oritomov/cdc/README.md

# Emulator (Arduino & Raspbery Pi) for<br>Audi Gamma CC Bose CD Changer 

### Preface

This isn't my biggest project, but it is most complicated and related to too much unknown to me things. It is my first Python code and my first Arduino project.

### Hardware

Audi Gamma CC Bose (HU) is my auto cassette player. It has ability to rule a CD Changer, not directly, but via specific Audi Interface (AI).

#### Audi Gamma CC Bose - Head Unit (HU)

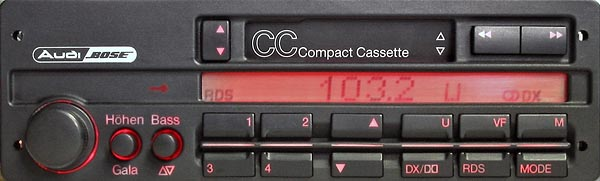
[picture p1: etc/img/Audo Gamma CC Bose.jpg]


#### Audi Interface 4A0 035 239, Blaupunkt 7 607 765 082 (AI) 

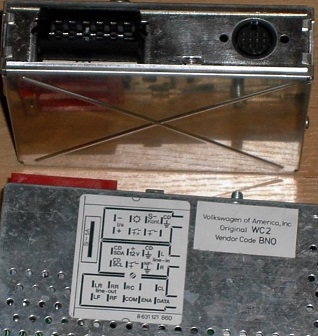
[picture p2: etc/img/4A0 035 239.jpg]

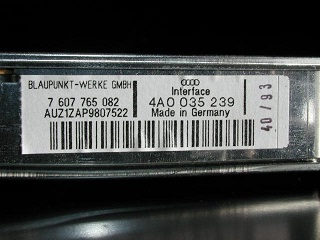
[picture p3: etc/img/Blaupunkt 7 607 765 082.jpg]


#### CD Changer (CDC)

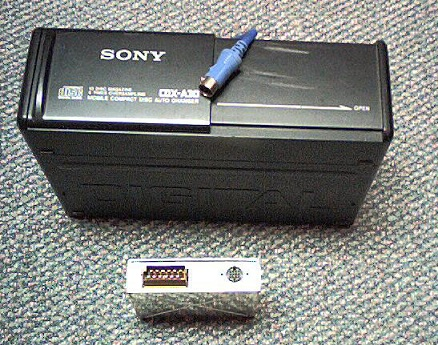
[picture p4: etc/img/CD_changer.jpg]


### I2C/TWI communication betwwen HU and AI

Even though communication with VAG's CD Changers is pretty well documented, I couldn't find any information about communication between my HU and the AI. This is what I surveyed.

The HU sends I2C/TWI signals to AI on 960 Hz (or sort of) to the address 0x40. ON is two bytes 0xA1 and 0x21, OFF is same bytes back order. Other signals what I riddle are from '^', 'v', '>>' and '<<' buttons hold and release. There are two more signals, one when HU doesn't like communication - I called "Cancel", and one more, what HU sends it from time to time instead of OFF.

#### OFF

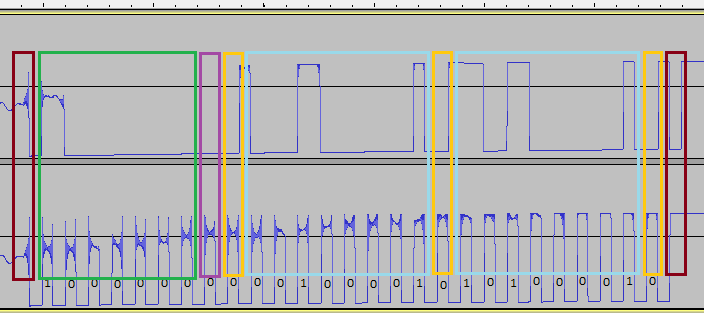
[picture p5: etc/img/off.png]


 * (Start)
 * 1000000 (7bit addrtess 0x40)
 * 0 (Write)
 * 0 (Ack)
 * 00100001 (8bit data 0x21)
 * 0 (Ack)
 * 10100001 (8bit data 0xA1)
 * 0 (Ack)
 * (Stop)
 
#### ON
 
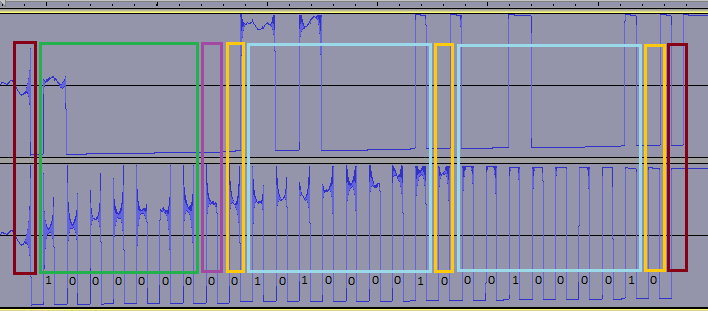
[picture p6: etc/img/on.png]


 * (Start)
 * 1000000 (7bit addrtess 0x40)
 * 0 (Write)
 * 0 (Ack)
 * 10100001 (8bit data 0xA1)
 * 0 (Ack)
 * 00100001 (8bit data 0x21)
 * 0 (Ack)
 * (Stop)

#### Display

Communication on the other direction is pretty ... incoherent. It looks like address and 3 bytes via I2C, but it is not. And there is no Ack signal in response. It should be around 30 ms after HU signal and after direction button release it repeats twice. And ditto any time when on display should appears something new. 

In order to display CD01TR01 it will looks like:

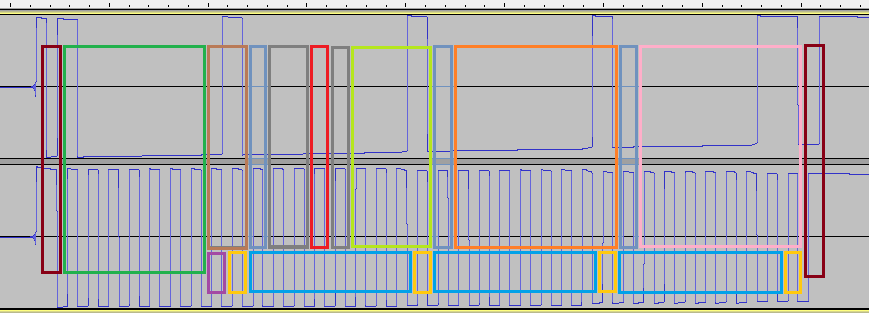
[picture p7: etc/img/gamma.png]


Down side I colored what it would look like if it was I2C. But it is:

 * (Start)
 * 1000000 (7bit address 0x40, same as I2C)
 * 01 (2 bits, similar to I2C Write & Ack, but there is no Ack level from the HU
 
------------------------------ 1st data chunk
 
 * 0 (1 bit, not used)
 * 00 (2 bits, ???)
 * 0 (1 bit, 1 means NO DISK)
 * 0 (1 bit, ???)
 * 0001 (4 bits, CD #)
 
------------------------------ 2nd data chunk
 
 * 0 (1 bit, not used)
 * 00000001 (8bit data TR #)
 
------------------------------ 3rd data chunk
 
 * 0 (1 bit, not used)
 * 00000011 (8bit data CRC value)
 * (Stop)

Check sum is CD + TR + 1, sometimes minus 0x10 in order not to overflow 0xFF.

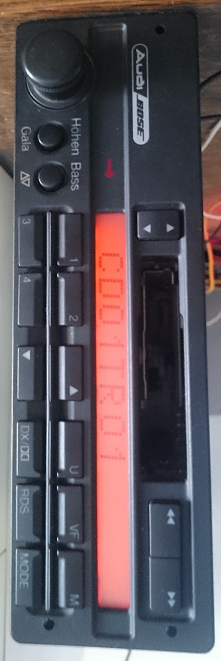
[picture p8: etc/img/cd01tr01.JPG]


### Emulator

I implemented the emulator from Arduino to replace the AI and Raspberry Pi to replace the CD Changer. I use separate DAC because that build in RPi is ... not good enough.

Communication between the Arduino and RPi is serial UART similar (but not same) to standard CDC communication.

Communication between the RPi and the DAC what I chose, indeed PCB5102A, is via I2S.

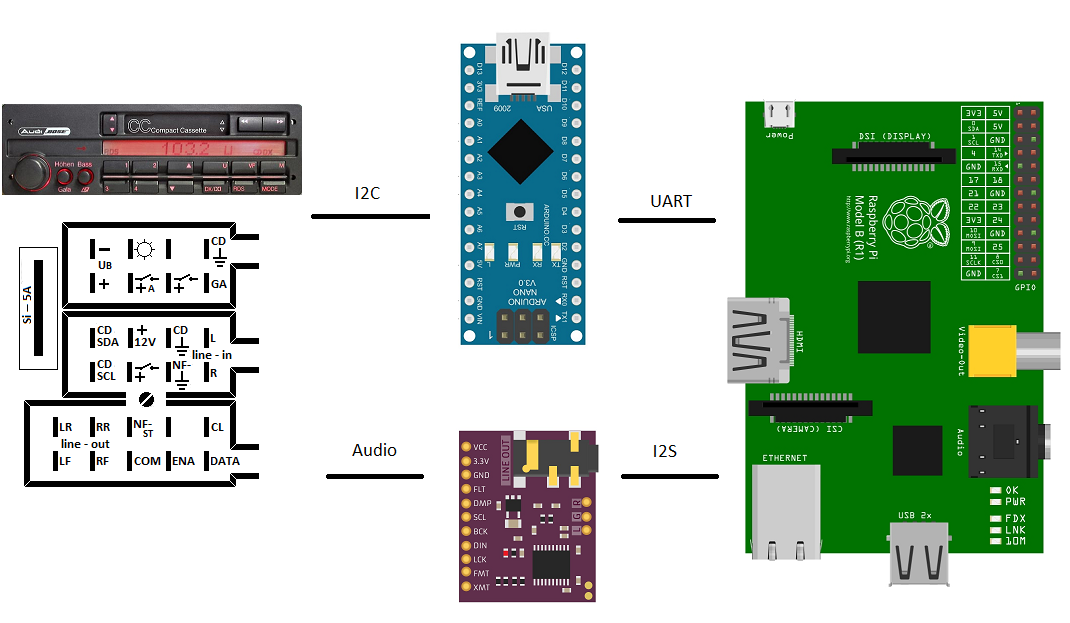
[picture p9: etc/img/emulator.png]


### Circuit

Power is based on LM2575-5.

Note: There is a trick. First hand shake of the HU comes around 0.4 seconds after HU power on. The Arduino takes more time for boot. Thats why I add two NPN transistors - one in order to lower acknowledge bit of I2C/TWI communication, and another one to cancel this after Arduino's boot.

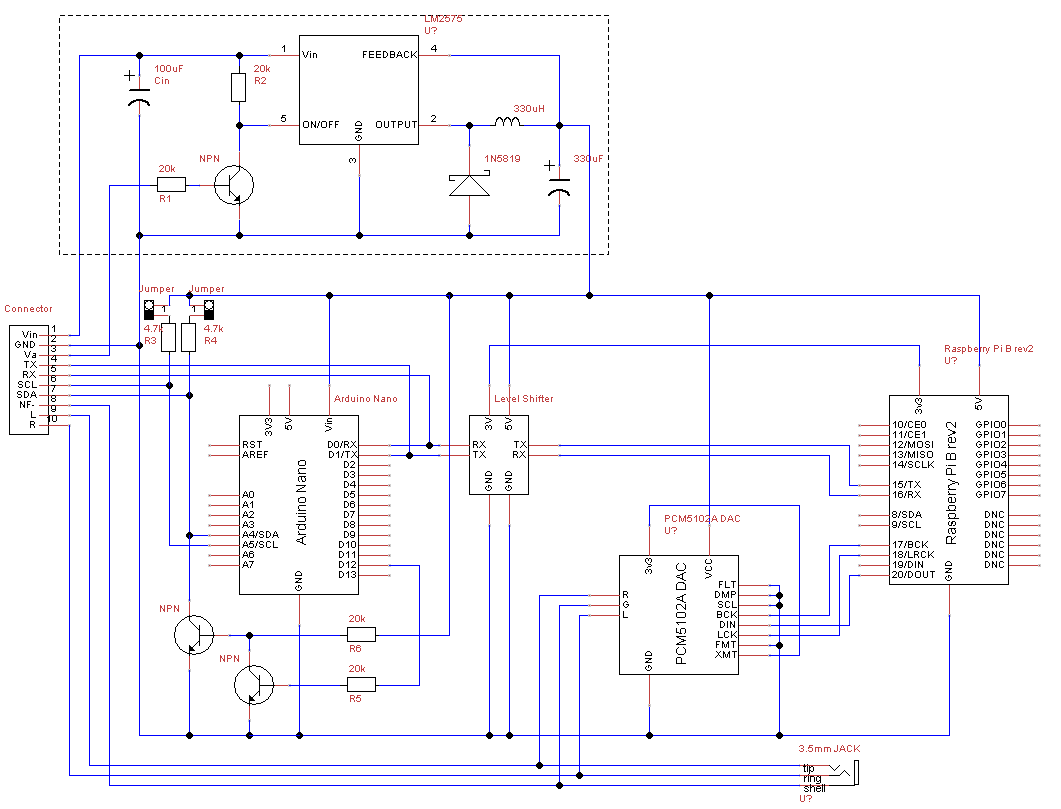
[picture p10: etc/cir/circuit.png]


### PCB

I've made a special PCB to hold everything. The connector to the HU is hand made 10 pins similar to common ISO connector.

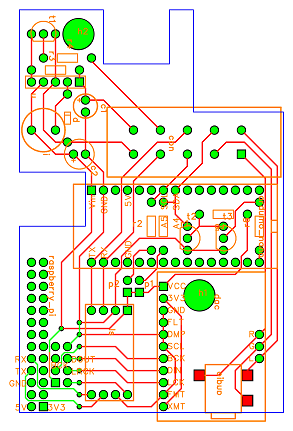
[picture p11: etc/pcb/cdc11.png]


### Release #1

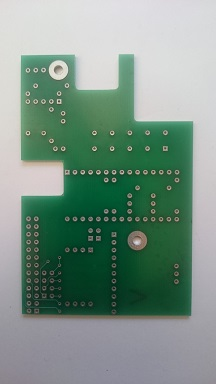
[picture p12: etc/img/rel_1_1.JPG]

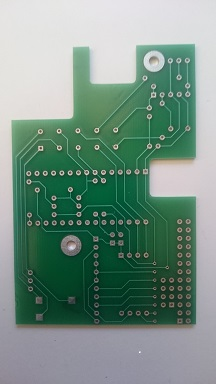
[picture p13: etc/img/rel_1_2.JPG]

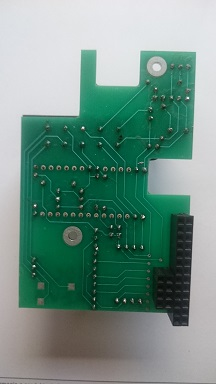
[picture p14: etc/img/rel_1_3.JPG]

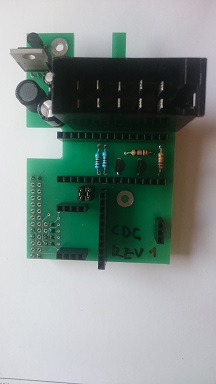
[picture p15: etc/img/rel_1_4.JPG]

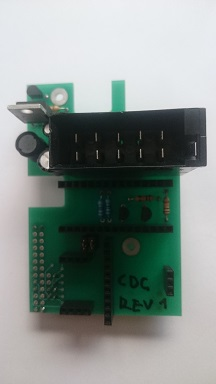
[picture p16: etc/img/rel_1_5.JPG]

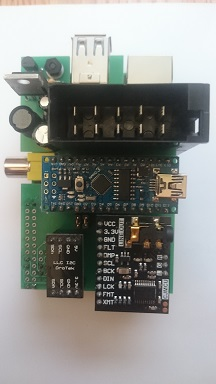
[picture p17: etc/img/rel_1_6.JPG]

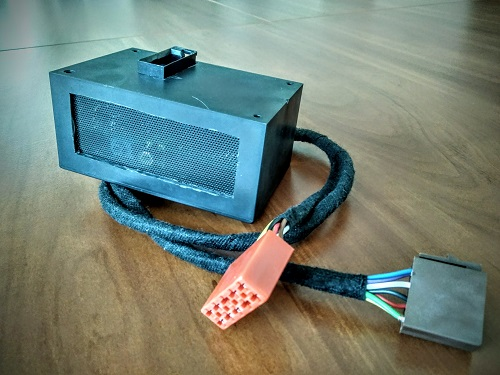
[picture p18: etc/img/boxed.jpg]


### Test

Release Candidate Test (https://www.youtube.com/watch?v=TbPQ_YEeIYg "Release Candidate Test")

### References

 * [VAG CDC Faker](http://dev.shyd.de/2013/09/avr-raspberry-pi-vw-beta-vag-cdc-faker/)
 * [Nick Gammon's page about I2C](http://gammon.com.au/i2c) / [How to use I2C-bus](http://www.ermicro.com/blog/?p=744)
 * [Raspberry Pi rev2 template with mounting holes](https://www.raspberrypi.org/blog/raspberry-pi-rev2-template-with-mounting-holes/)
 * efficient 12V to 5V convertor [LM2575](http://www.ti.com.cn/cn/lit/ds/symlink/lm1575.pdf)
 * DAC [PCM5102A](https://www.raspberrypi.org/forums/viewtopic.php?f=45&t=57069)  ([Beyond ES9023 PCM1794](https://www.google.bg/search?q=Beyond+ES9023+PCM1794))

### Utilities

 * [TinyCAD](https://sourceforge.net/projects/tinycad/)
 * [FreePcb](http://www.freepcb.com/)
 
### Special Thanks

 * ALOHAta
 * Lars Frerichs
 * grizzly@audibg (George)
