oritomov/cdc/etc/img/Audo Gamma CC Bose pinout.jpg

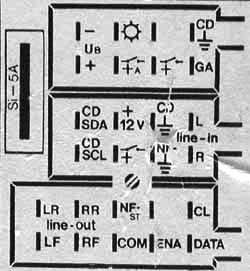
etc/img/Audo Gamma CC Bose pinout.jpg
