oritomov/cdc/etc/img/cancel.png

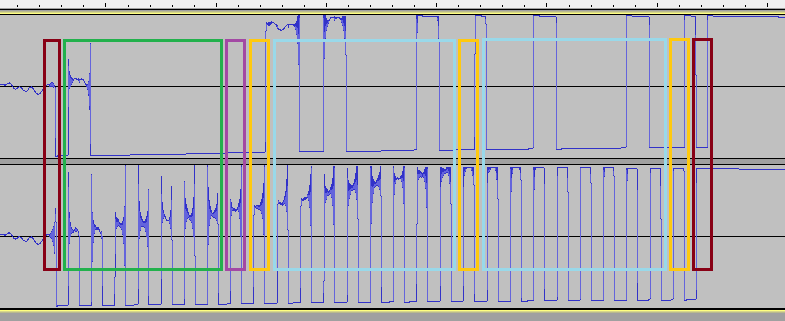
etc/img/cancel.png
