oritomov/cdc/etc/img/DAC.jpg

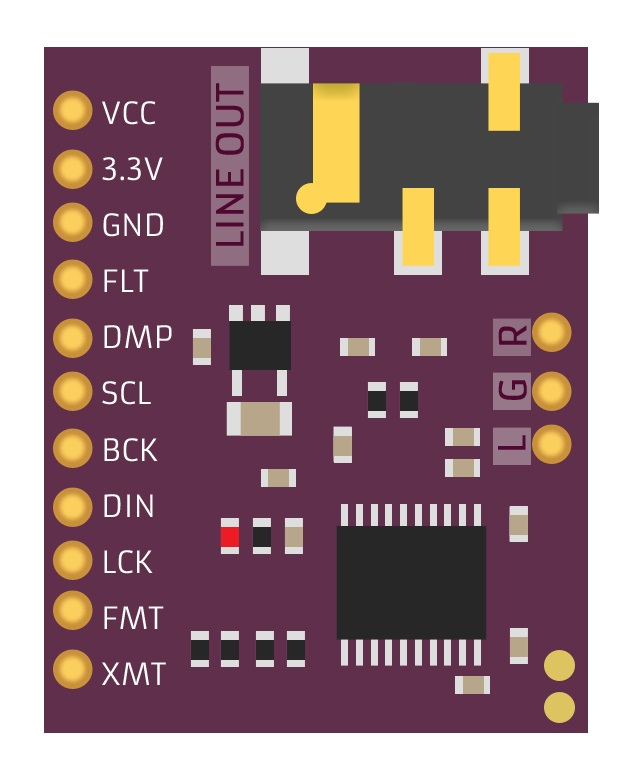
etc/img/DAC.jpg
