oritomov/cdc/etc/img/nano.jpg

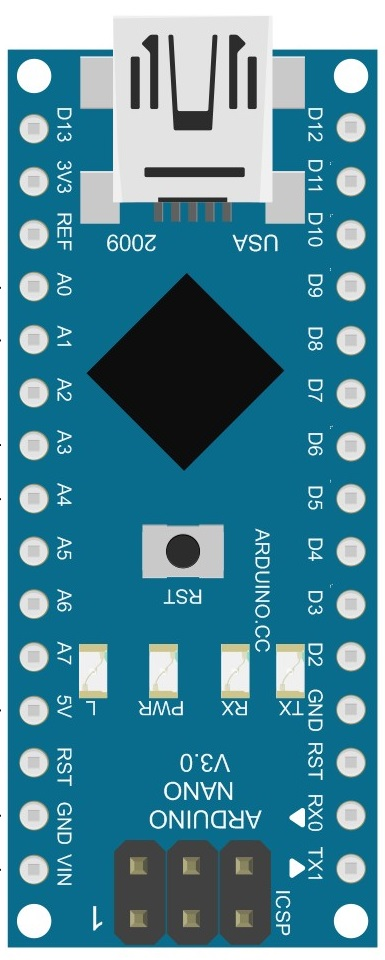
etc/img/nano.jpg
