oritomov/cdc/etc/pcb/cdc2.png

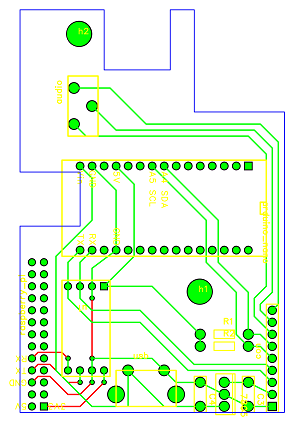
etc/pcb/cdc2.png
