oritomov/cdc/etc/pcb/cdc3.png

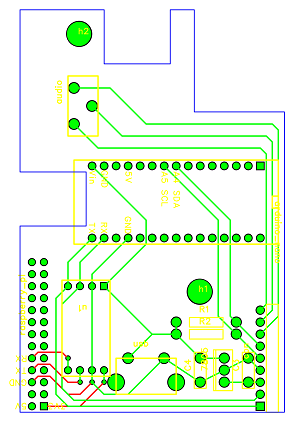
etc/pcb/cdc3.png
