oritomov/cdc/etc/pcb/cdc5.png

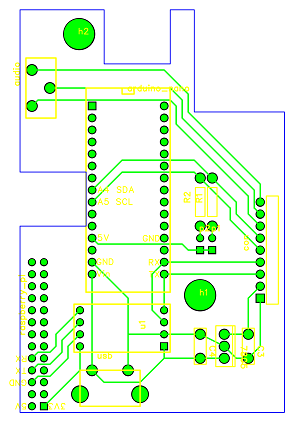
etc/pcb/cdc5.png
