oritomov/cdc/etc/pcb/cdc6.png

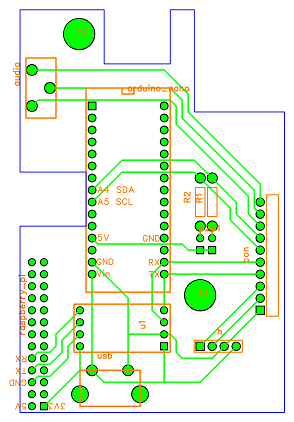
etc/pcb/cdc6.png
