oritomov/cdc/etc/pcb/cdc9.png

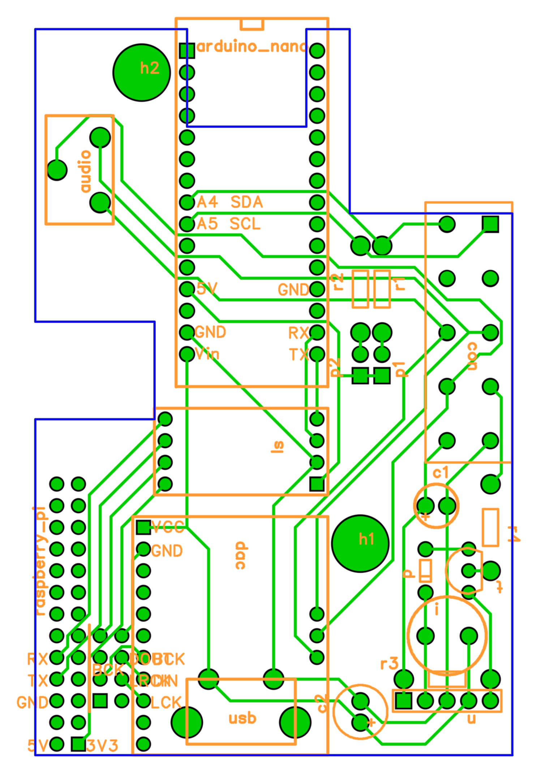
etc/pcb/cdc9.png
