oritomov/cdc/etc/pcb/cdc10.png

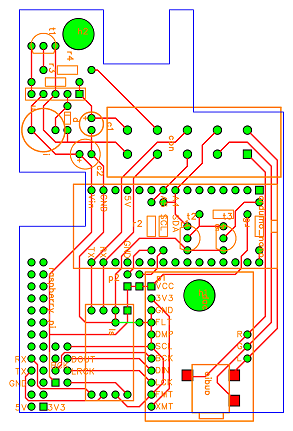
etc/pcb/cdc10.png
