oritomov/cdc/etc/pcb/cdc10_bottom.png

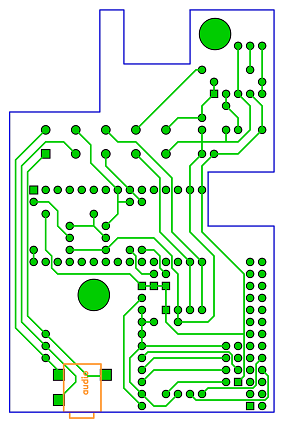
etc/pcb/cdc10_bottom.png
