oritomov/cdc/etc/pcb/cdc10_top.png

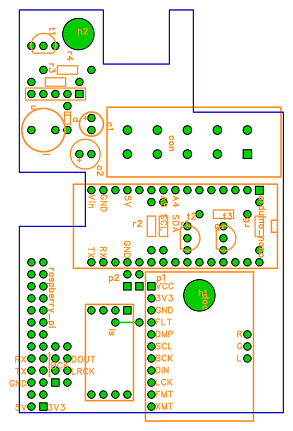
etc/pcb/cdc10_top.png
