oritomov/cdc/(list of files, drawings)

Other design files:
etc/cir/cdc.dsn
