oritomov/cdc/(commit log)

2016-06-06 Arduino twi/i2c interface
2016-06-14 Revert "fix playing"
    This reverts commit bd858953e0993b584c5ca449d1137790ad47a56f.
    [cdc.py]
2016-06-14 Revert "Revert "fix playing""
    This reverts commit 49b65d82bb1082ba0df1a6f15c9494bfd9b6e5c0.
    [cdc.py]
2016-06-29 Update README.md
    circuit
2016-08-28 fix read_config & play_cd
    [cdc.py]
2016-08-30 fix pcb
2016-09-07 pcb 2
2016-09-07 Revert "pcb 2"
    This reverts commit 989e606f6616aa31b1218f508893f0030bdda13a.
2016-09-10 pcb 3
2016-09-11 fix pcb 3
2016-09-14 fix circuit
    [cdc.dsn]
2016-09-21 pcb up to v5
    [cdc.dsn]
2016-09-23 fix set status time
    [cdc.py, vag.py]
2016-09-26 pcb 5
2016-09-30 fix power circuit
    [cdc.dsn]
2016-10-02 pcb 6
2016-10-11 pcb 7
2016-10-17 add GPIO Pin on for 30 sec
2016-12-26 pcb 7 & 8
2016-12-26 add dac
    [cdc.dsn]
2016-12-26 fix P5
    [cdc.dsn]
2016-12-26 pcb 9
2016-12-29 fix pcb 9
2017-03-05 add SDA ground before arduino boot
    [cdc.dsn]
2017-03-05 add off SDA ground
2017-03-05 fix pcb 10
2017-03-19 fix dac
    [cdc.dsn]
2017-03-20 fix pcb10
2017-03-25 fix try to connect until answer
    [cdc.ino, vag.py]
2017-03-25 fix stop rpi gpio
    [cdc.py]
2017-03-31 pcb rel 1
2017-03-31 fix pcb img
2017-04-01 pcb 11
2017-04-23 fix sd card change
    [cdc.py]
2017-05-20 change next cd code in order to fix initial communication
    [cdc.ino, vag.py]
2017-06-07 swap buttons according to Lars
    [cdc.ino]
2018-01-27 fix arduino cd/tr info
    [cdc.ino, gamma.h, gamma.ino, vag.h]
2018-01-27 fix rpi cd/tr info
    [cdc.py, vag.py]
2018-01-28 fix gamma check sum
    [cdc.ino, gamma.ino]
2018-01-28 fix do not status before exists
    [cdc.ino]
2018-02-03 arduino left-right buttons
2018-02-10 fix arduino handshake
